mamejay/C64-USB-C-PD-Power-Adapter/Docs/top_3d_routed.png

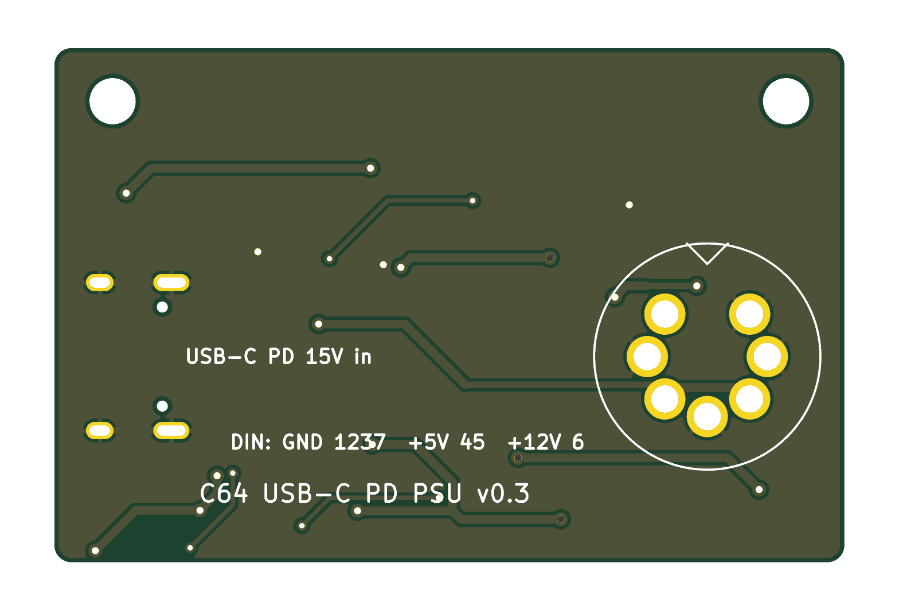
Docs/top_3d_routed.png
