mamejay/C64-USB-C-PD-Power-Adapter/Hardware v0.4/Docs/routing_plot.png

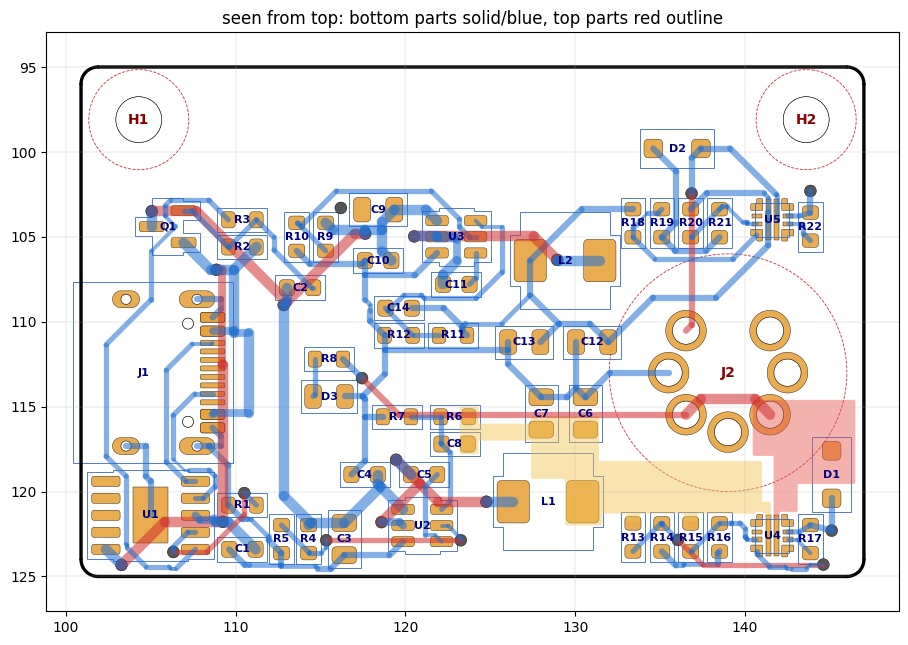
Hardware v0.4/Docs/routing_plot.png
