mamejay/C64-USB-C-PD-Power-Adapter/Hardware v0.4/Docs/top_3d.png

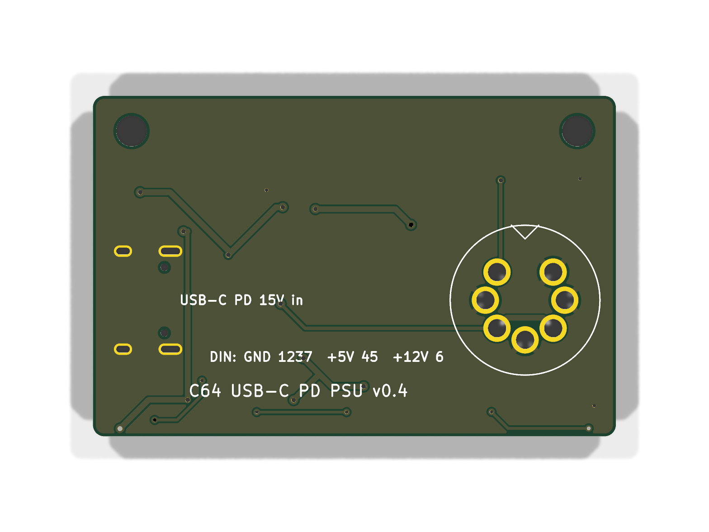
Hardware v0.4/Docs/top_3d.png
