mamejay/C64-USB-C-PD-Power-Adapter/Hardware v0.4/JLCPCB Output/C64 USB-C PD Power Adapter - BOM.csv

Comment | Designator | Footprint | LCSC Part #
1uF/50V | C1 | 0603 | C15849
100nF/50V | C2,C4,C5,C10,C11 | 0603 | C14663
10uF/25V | C3,C9 | 0805 | C15850
22uF/25V | C6,C7,C12,C13 | 0805 | C45783
100pF | C8,C14 | 0603 | C14858
SMF5.0A | D1 | SOD-123F | C19077497
SMF13A | D2 | SOD-123F | C41376087
GREEN | D3 | 0805 | C2297
USB-C (power in) | J1 | TYPE-C-31-M-12 | C165948
10uH | L1,L2 | FXL0530 | C177248
AO3401A | Q1 | SOT-23 | C15127
56k | R1 | 0603 | C23206
100k | R2,R3,R11,R13 | 0603 | C25803
470k | R4,R9 | 0603 | C23178
47k | R5,R10,R14,R18 | 0603 | C25819
75k | R6,R15 | 0603 | C23242
10k | R7,R19 | 0603 | C25804
1k | R8,R17 | 0603 | C21190
5.1k | R12 | 0603 | C23186
20k | R16 | 0603 | C4184
51k | R20 | 0603 | C23196
4.7k | R21 | 0603 | C23162
2.2k | R22 | 0603 | C4190
CH224A | U1 | SSOP-10 | C42459160
TPS54302DDCR | U2,U3 | TSOT-23-6 | C311983
TPS259470ARPWR | U4,U5 | TI_RPW0010A_VQFN-10-HR_2x2mm | C3662799
