mamejay/C64-USB-C-PD-Power-Adapter/C128 Version/JLCPCB Output/C128 USB-C PD Power Adapter - BOM.csv

Comment | Designator | Footprint | LCSC Part #
1uF/50V | C1,C16 | 0603 | C15849
100nF/50V | C2,C4,C5,C10,C11,C17 | 0603 | C14663
10uF/25V | C3,C9,C15 | 0805 | C15850
22uF/25V | C6,C7,C12,C13,C18 | 0805 | C45783
100pF | C14 | 0603 | C14858
SMF5.0A | D1 | SOD-123F | C19077497
SMF13A | D2 | SOD-123F | C41376087
GREEN | D3 | 0805 | C2297
0R | F2 | 1206 | C17888
USB-C (power in) | J1 | TYPE-C-31-M-12 | C165948
4.7uH | L1 | L_Cenker_CKCS8040 | C354638
10uH | L2 | FXL0530 | C177248
AO3401A | Q1 | SOT-23 | C15127
56k | R1 | 0603 | C23206
100k | R2,R3,R11,R13,R15 | 0603 | C25803
470k | R4,R9 | 0603 | C23178
51k | R5 | 0603 | C23196
75k | R6 | 0603 | C23242
10k | R7 | 0603 | C25804
1k | R8 | 0603 | C21190
47k | R10,R14 | 0603 | C25819
5.1k | R12 | 0603 | C23186
27k | R16 | 0603 | C22967
750R | R17 | 0603 | C23241
CH224A | U1 | SSOP-10 | C42459160
SY8205FCC | U2 | SOIC-8-1EP_3.9x4.9mm_P1.27mm_EP2.41x3.3mm_ThermalVias | C111875
TPS54302DDCR | U3 | TSOT-23-6 | C311983
TPS259470ARPWR | U4 | TI_RPW0010A_VQFN-10-HR_2x2mm | C3662799
