mamejay/C64-USB-C-PD-Power-Adapter/Case (3D print)/c64_pd_psu_case_lid.stl

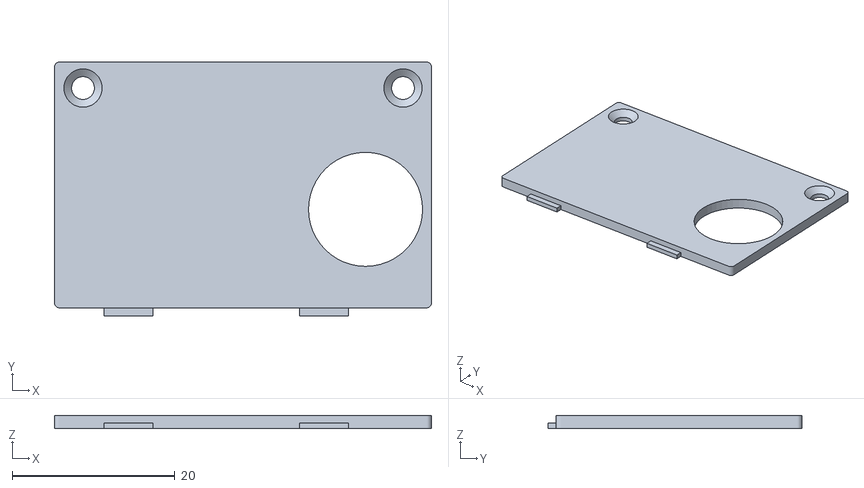
[picture p7: CAD file, 2026-11-03]
Case (3D print)/c64_pd_psu_case_lid.stl
46.3 x 31.2 x 1.60
