mamejay/C64-USB-C-PD-Power-Adapter/Case (3D print)/c64_pd_psu_case_base.stl

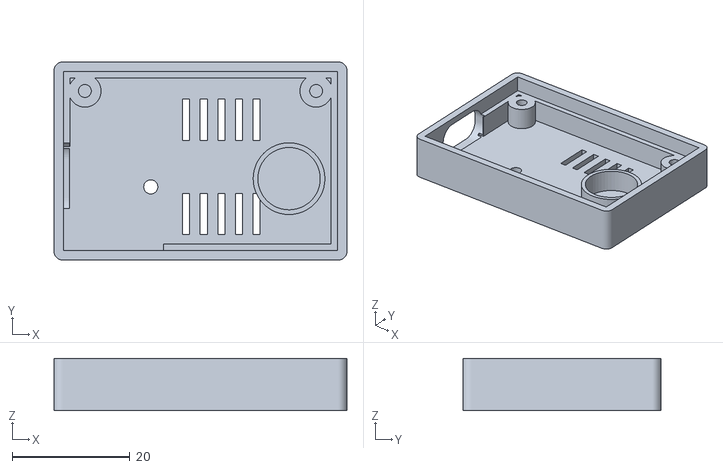
[picture p8: CAD file, 2026-11-03]
Case (3D print)/c64_pd_psu_case_base.stl
49.8 x 33.7 x 8.90
