mamejay/C64-USB-C-PD-Power-Adapter/Case (3D print)/render_base_under.png

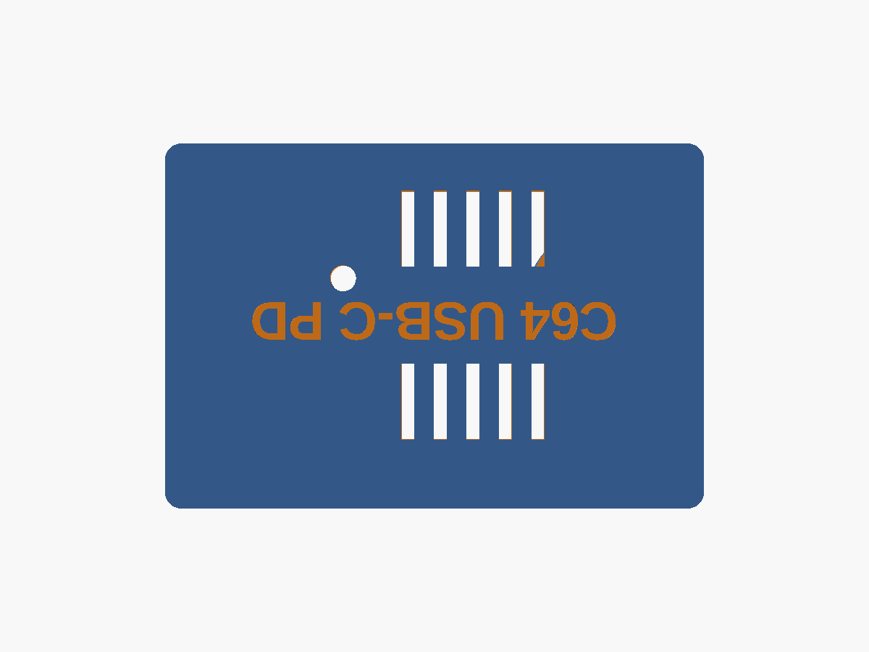
Case (3D print)/render_base_under.png
