mamejay/C64-USB-C-PD-Power-Adapter/Hardware v0.4/Docs/C64 USB-C PD Power Adapter v0.4 - schematic.pdf

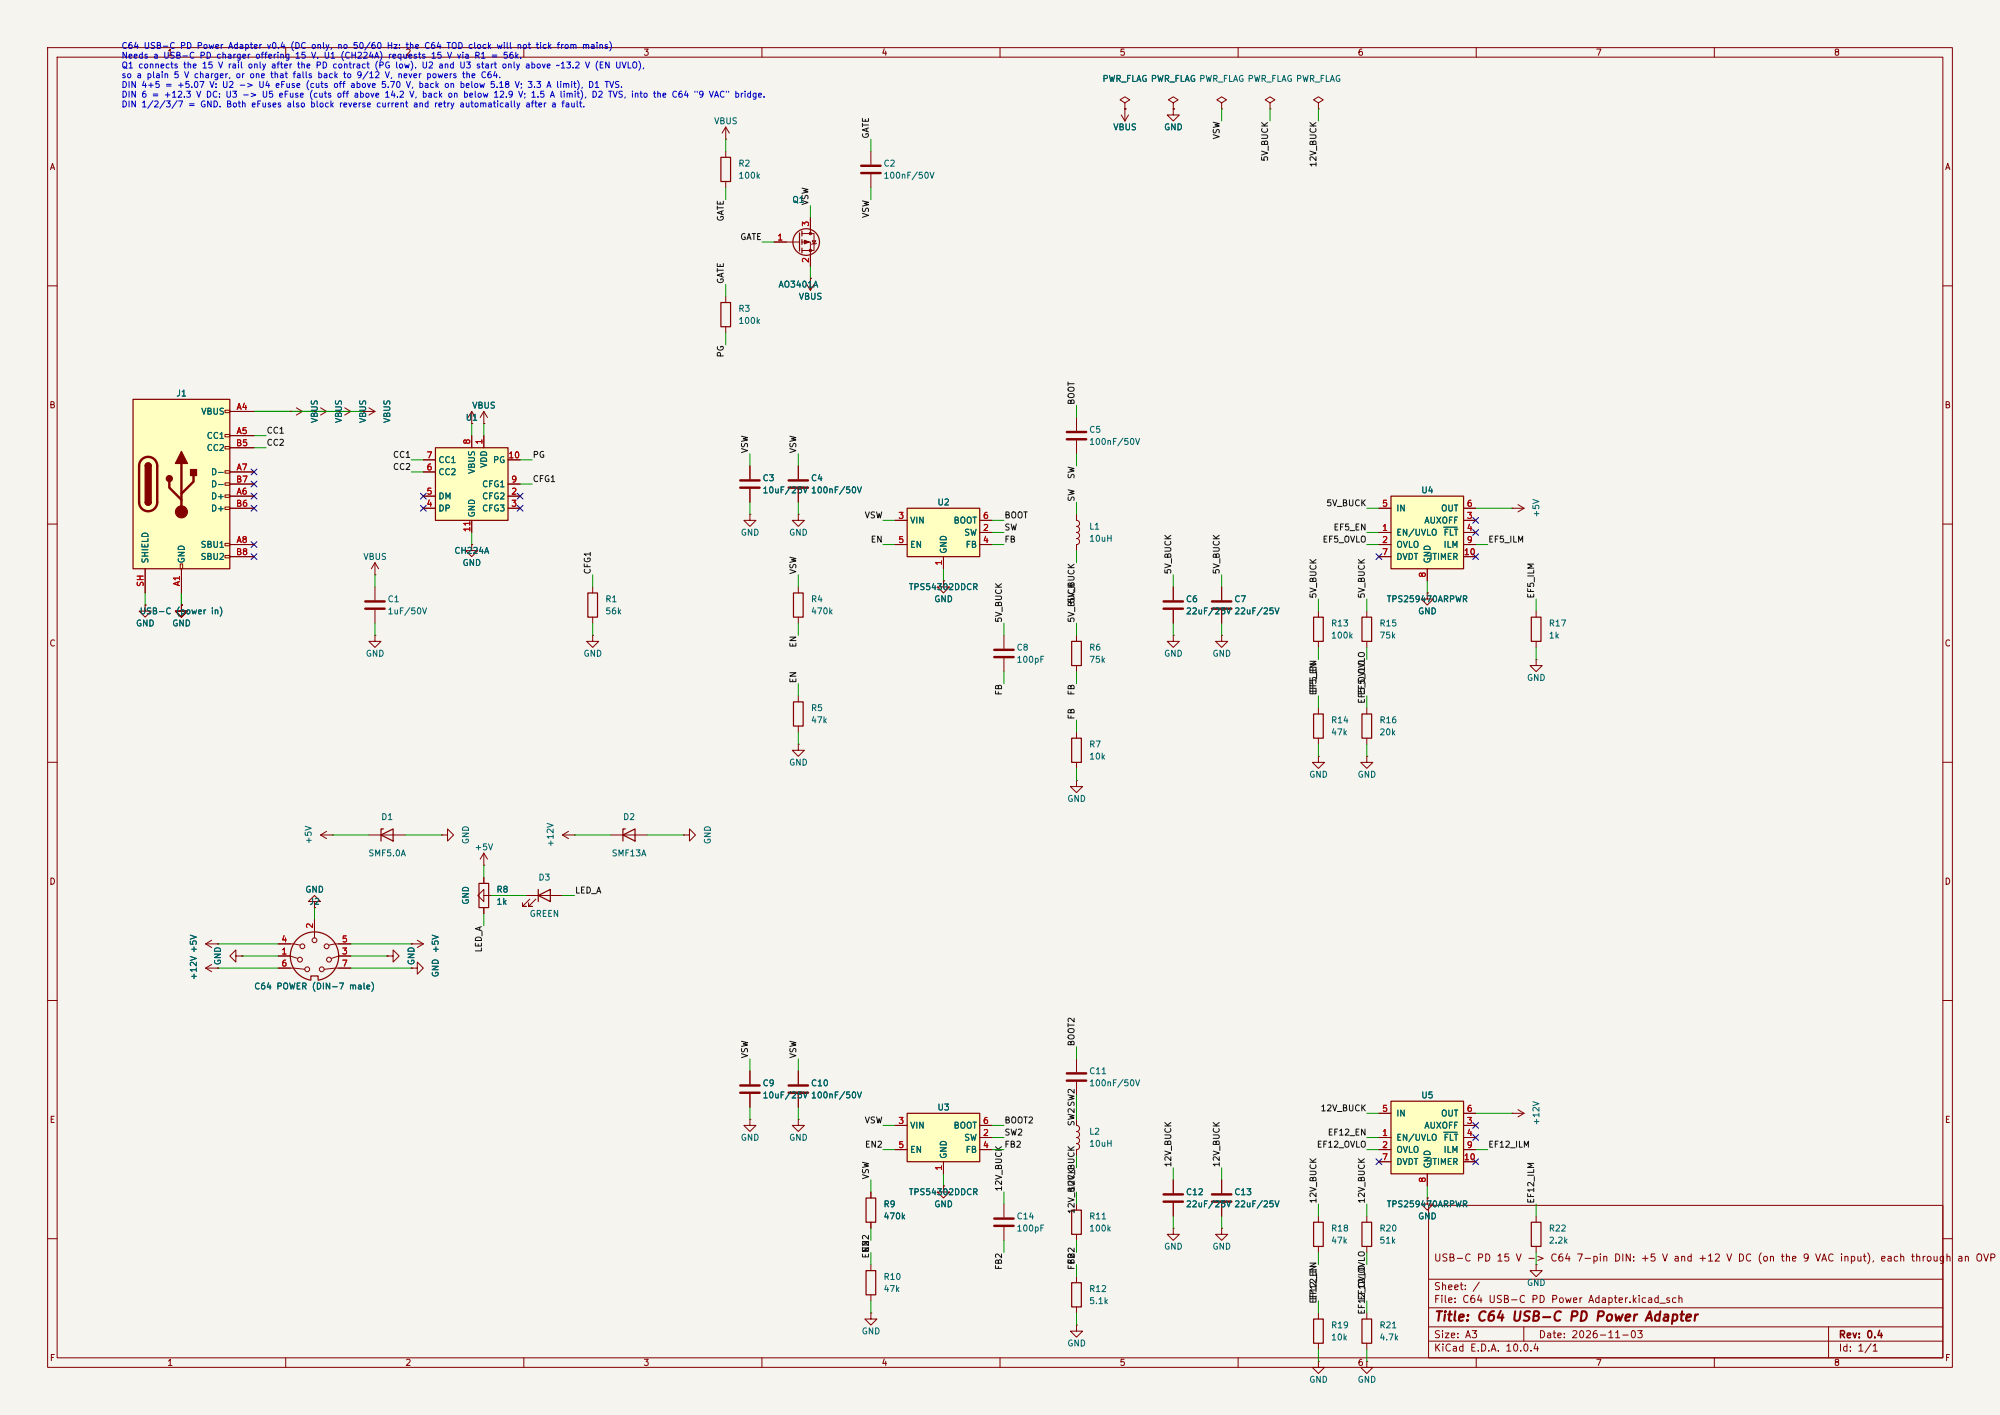
[picture p13: page 1]

J1 USB-C (power in) GND A1

8 CFG1 9 PG 10 GND 11 U1 CH224A GND VBUS GND

USB-C PD 15 V -> C64 7-pin DIN: +5 V and +12 V DC (on the 9 VAC input), each through an OVP eFuse

Sheet: /
File: C64 USB-C PD Power Adapter.kicad_sch
Title: C64 USB-C PD Power Adapter

Size: A3 | Rev: 0.4
KiCad E.D.A. 10.0.4 | Id: 1/1 | F Date: 2026-11-03
