mamejay/C64-USB-C-PD-Power-Adapter/C128 Version/Docs/C128 USB-C PD Power Adapter - schematic.pdf

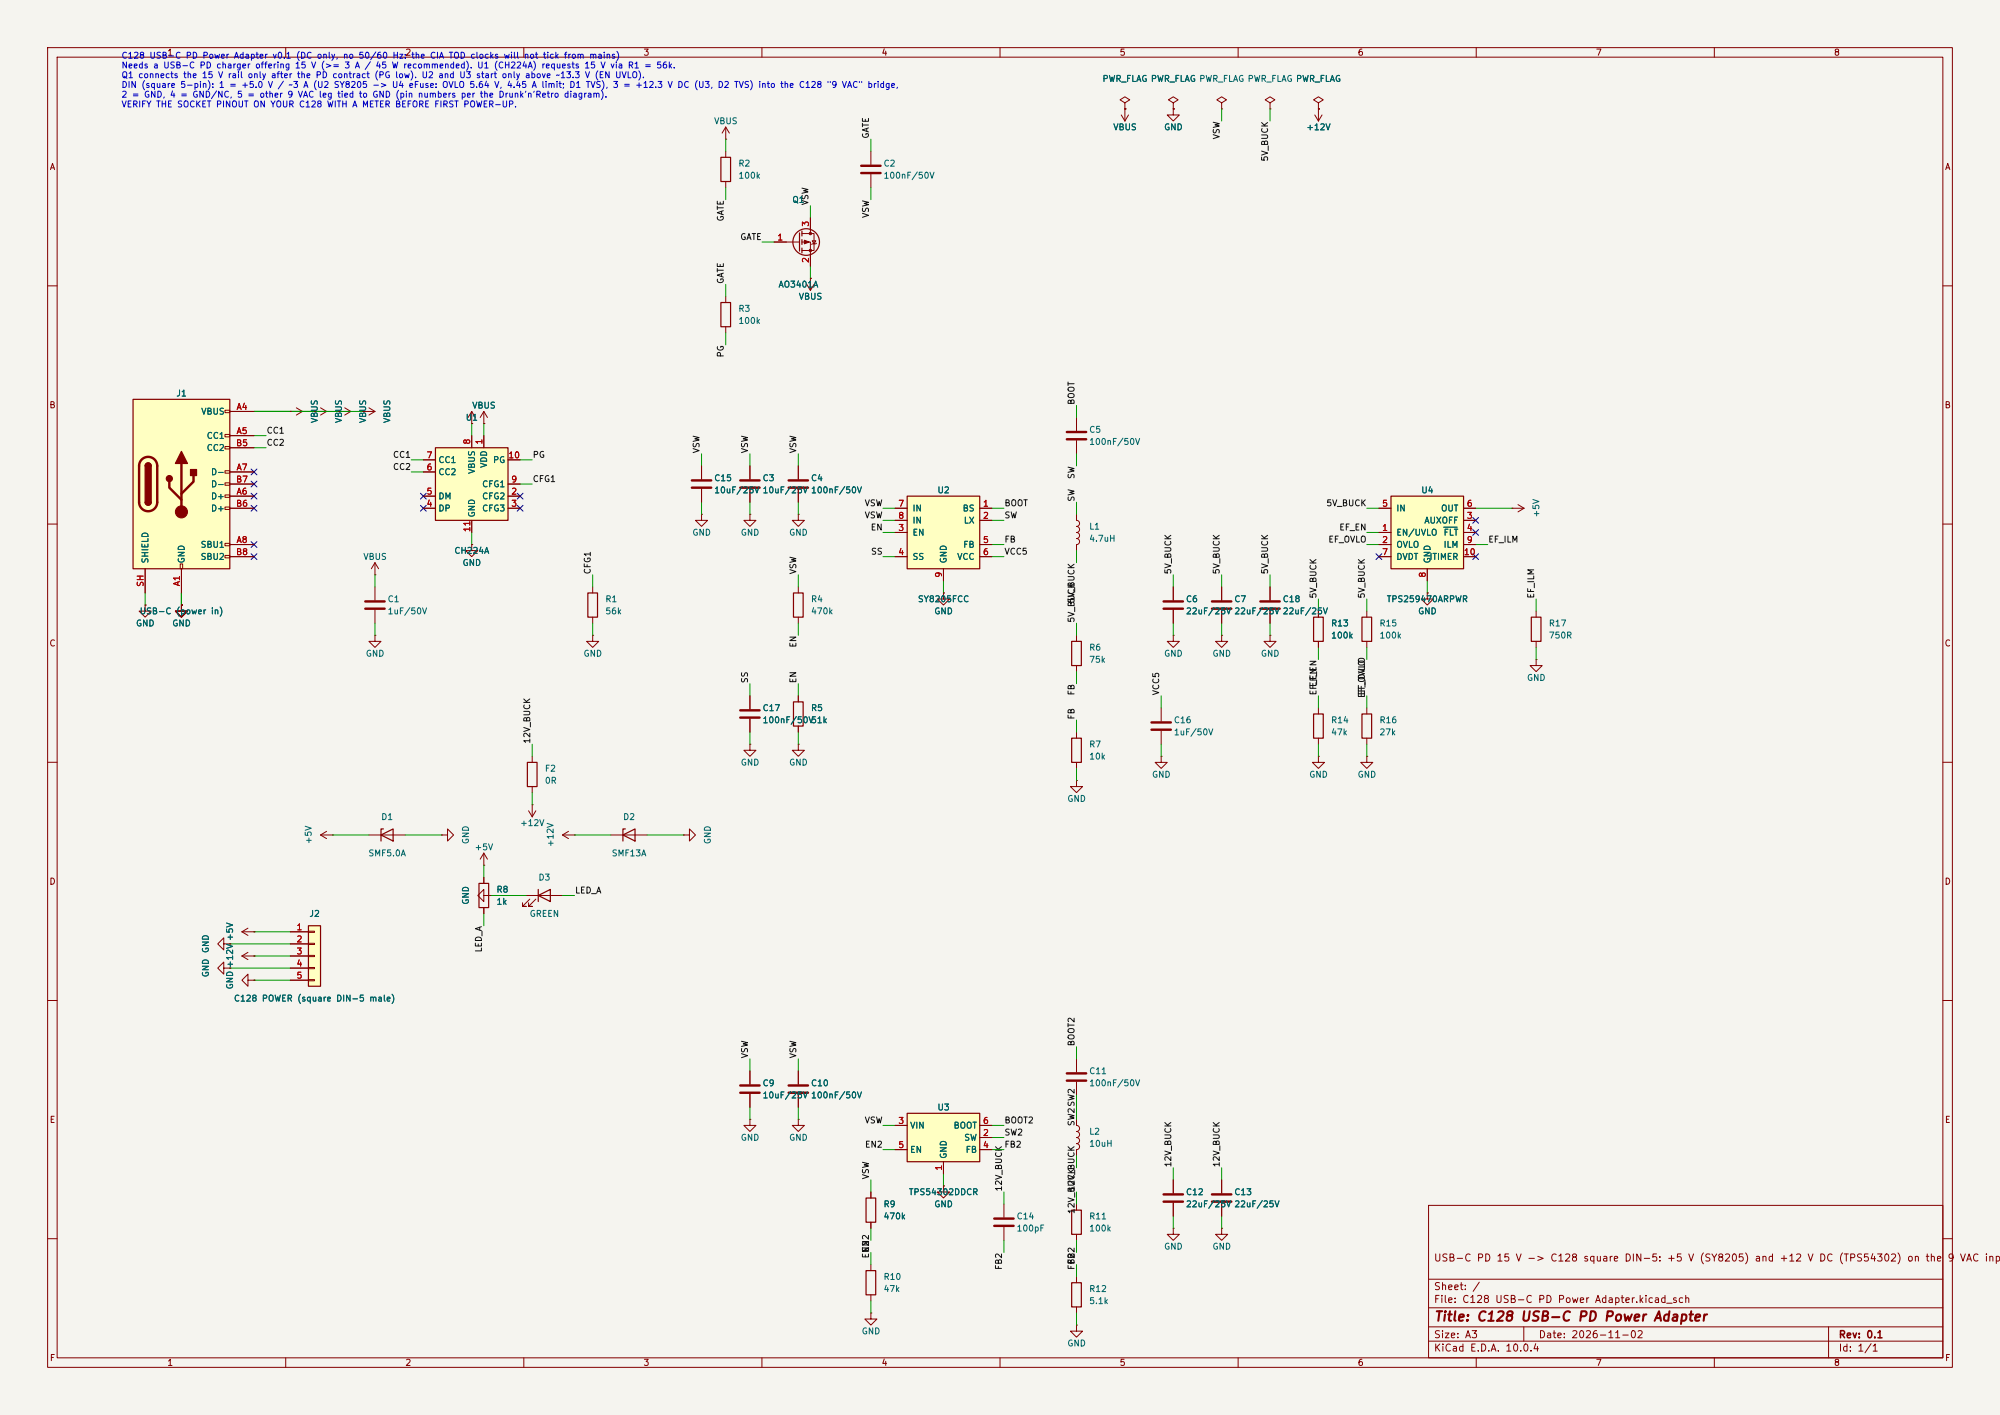
[picture p14: page 1]

J1 USB-C (power in) GND A1

8 CFG1 9 PG 10 GND 11 VBUS GND VBUS VBUS VBUS VBUS +5V GND +12V GND GND GNDR8

J2 C128 POWER (square DIN-5 male)

J2 C128 POWER (square DIN-5 male) 1

Sheet: /
File: C128 USB-C PD Power Adapter.kicad_sch
Title: C128 USB-C PD Power Adapter

Size: A3 | Rev: 0.1
KiCad E.D.A. 10.0.4 | Id: 1/1 | F Date: 2026-11-02
