mamejay/C64-USB-C-PD-Power-Adapter/Hardware v0.4/KiCad/C64 USB-C PD Power Adapter.kicad_pcb

## KiCad design Hardware v0.4/KiCad/C64 USB-C PD Power Adapter.kicad_pcb (2026-11-03)

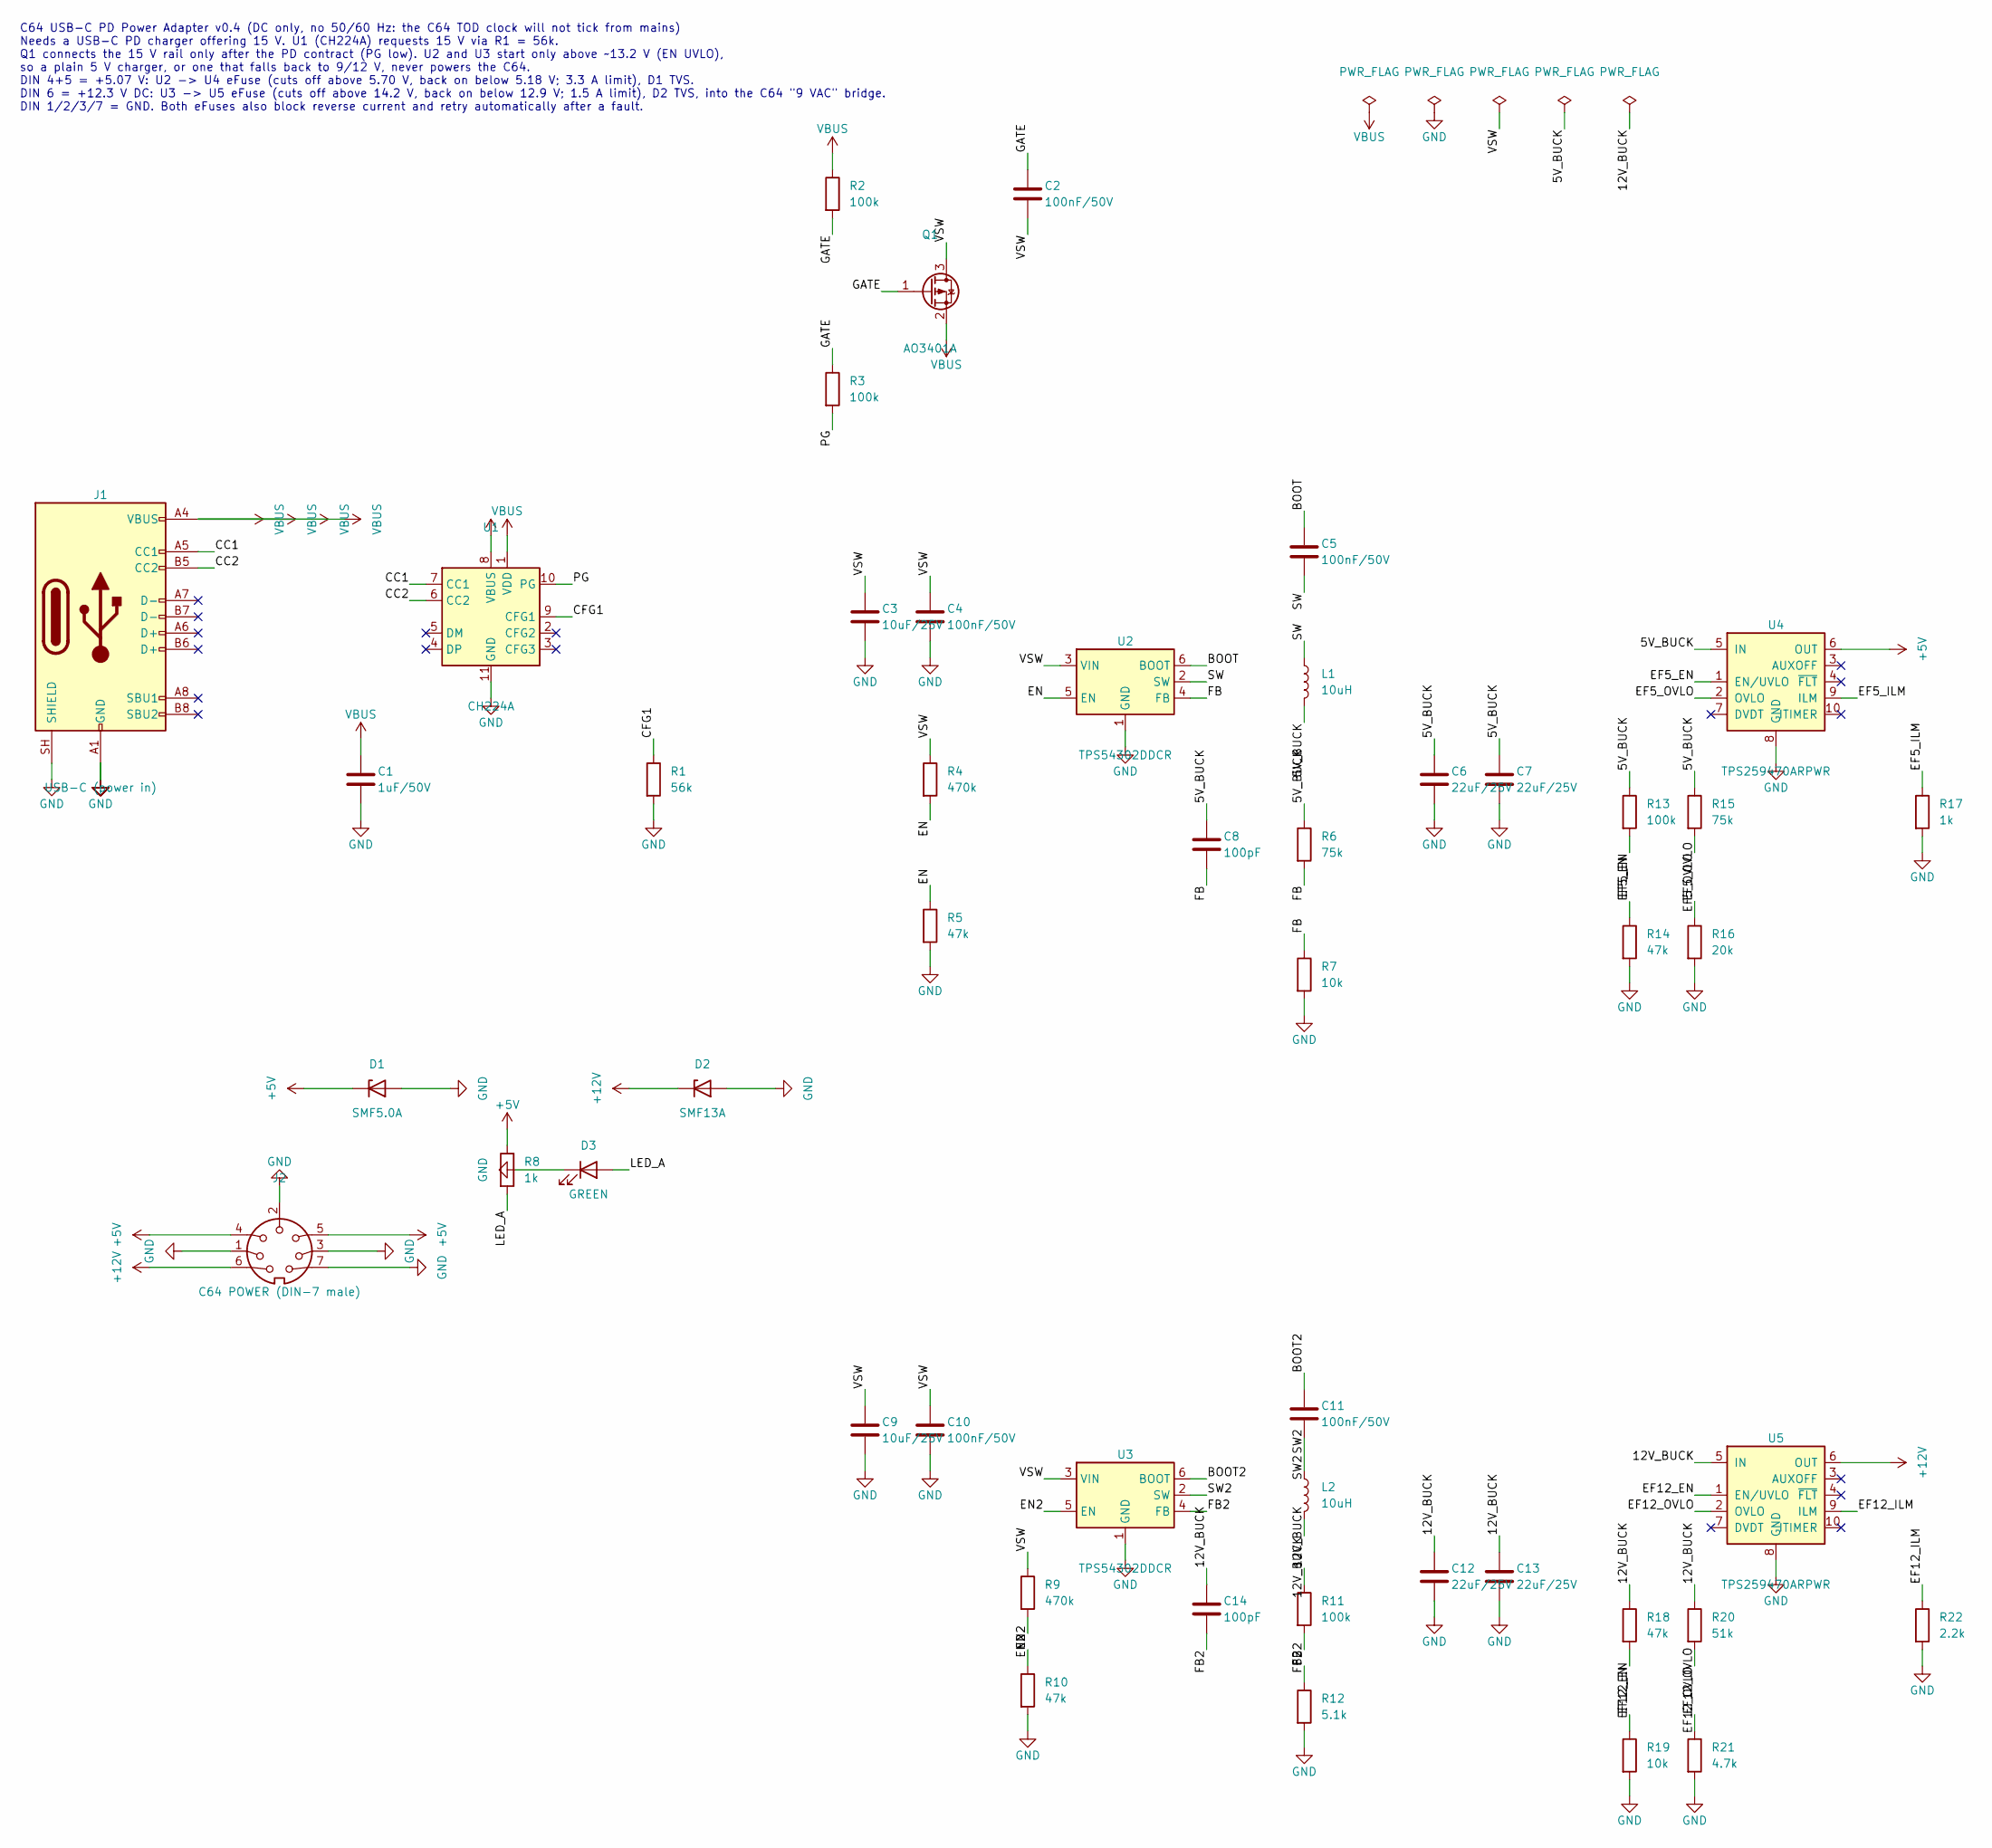
[picture p15: schematic C64 USB-C PD Power Adapter.kicad_sch]

Parts:
C1: 1uF/50V; C_0603_1608Metric; LCSC C15849
C2, C4, C5, C10, C11: 100nF/50V; C_0603_1608Metric; LCSC C14663
C3, C9: 10uF/25V; C_0805_2012Metric; LCSC C15850
C6, C7, C12, C13: 22uF/25V; C_0805_2012Metric; LCSC C45783
C8, C14: 100pF; C_0603_1608Metric; LCSC C14858
D1: SMF5.0A; D_SOD-123F; LCSC C19077497
D2: SMF13A; D_SOD-123F; LCSC C41376087
D3: GREEN; LED_0805_2012Metric; LCSC C2297
J1: USB-C (power in); USB_C_Receptacle_HRO_TYPE-C-31-M-12; LCSC C165948
J2: C64 POWER (DIN-7 male); DIN-7_Male_PCB_C64
L1, L2: 10uH; L_Changjiang_FXL0530; LCSC C177248
Q1: AO3401A; SOT-23; LCSC C15127
R1: 56k; R_0603_1608Metric; LCSC C23206
R2, R3, R11, R13: 100k; R_0603_1608Metric; LCSC C25803
R4, R9: 470k; R_0603_1608Metric; LCSC C23178
R5, R10, R14, R18: 47k; R_0603_1608Metric; LCSC C25819
R6, R15: 75k; R_0603_1608Metric; LCSC C23242
R7, R19: 10k; R_0603_1608Metric; LCSC C25804
R8, R17: 1k; R_0603_1608Metric; LCSC C21190
R12: 5.1k; R_0603_1608Metric; LCSC C23186
R16: 20k; R_0603_1608Metric; LCSC C4184
R20: 51k; R_0603_1608Metric; LCSC C23196
R21: 4.7k; R_0603_1608Metric; LCSC C23162
R22: 2.2k; R_0603_1608Metric; LCSC C4190
U1: CH224A; SSOP-10-1EP_3.9x4.9mm_P1mm_EP2.1x3.3mm; LCSC C42459160
U2, U3: TPS54302DDCR; TSOT-23-6; LCSC C311983
U4, U5: TPS259470ARPWR; TI_RPW0010A_VQFN-10-HR_2x2mm; LCSC C3662799

Connections:
+5V: D1.1 (K), J2.4, J2.5, R8.1, U4.6 (OUT)
+12V: D2.1 (K), J2.6, U5.6 (OUT)
/5V_BUCK: C6.1, C7.1, C8.1, L1.2, R6.1, R13.1, R15.1, U4.5 (IN)
/12V_BUCK: C12.1, C13.1, C14.1, L2.2, R11.1, R18.1, R20.1, U5.5 (IN)
/BOOT: C5.1, U2.6 (BOOT)
/BOOT2: C11.1, U3.6 (BOOT)
/CC1: J1.A5 (CC1), U1.7 (CC1)
/CC2: J1.B5 (CC2), U1.6 (CC2)
/CFG1: R1.1, U1.9 (CFG1)
/EF5_EN: R13.2, R14.1, U4.1 (EN/UVLO)
/EF5_ILM: R17.1, U4.9 (ILM)
/EF5_OVLO: R15.2, R16.1, U4.2 (OVLO)
/EF12_EN: R18.2, R19.1, U5.1 (EN/UVLO)
/EF12_ILM: R22.1, U5.9 (ILM)
/EF12_OVLO: R20.2, R21.1, U5.2 (OVLO)
/EN: R4.2, R5.1, U2.5 (EN)
/EN2: R9.2, R10.1, U3.5 (EN)
/FB: C8.2, R6.2, R7.1, U2.4 (FB)
/FB2: C14.2, R11.2, R12.1, U3.4 (FB)
/GATE: C2.1, Q1.1 (G), R2.2, R3.1
/LED_A: D3.2 (A), R8.2
/PG: R3.2, U1.10 (PG)
/SW: C5.2, L1.1, U2.2 (SW)
/SW2: C11.2, L2.1, U3.2 (SW)
/VSW: C2.2, C3.1, C4.1, C9.1, C10.1, Q1.3 (D), R4.1, R9.1, U2.3 (VIN), U3.3 (VIN)
GND: C1.2, C3.2, C4.2, C6.2, C7.2, C9.2, C10.2, C12.2, C13.2, D1.2 (A), D2.2 (A), D3.1 (K), J1.A1 (GND), J1.A12 (GND), J1.B1 (GND), J1.B12 (GND), J1.SH (SHIELD), J2.1, J2.2, J2.3, J2.7, R1.2, R5.2, R7.2, R10.2, R12.2, R14.2, R16.2, R17.2, R19.2, R21.2, R22.2, U1.11 (GND), U2.1 (GND), U3.1 (GND), U4.8 (GND), U5.8 (GND)
VBUS: C1.1, J1.A4 (VBUS), J1.A9 (VBUS), J1.B4 (VBUS), J1.B9 (VBUS), Q1.2 (S), R2.1, U1.1 (VDD), U1.8 (VBUS)

Notes on the sheet:
C64 USB-C PD Power Adapter v0.4 (DC only, no 50/60 Hz: the C64 TOD clock will not tick from mains) Needs a USB-C PD charger offering 15 V. U1 (CH224A) requests 15 V via R1 = 56k. Q1 connects the 15 V rail only after the PD contract (PG low). U2 and U3 start only above ~13.2 V (EN UVLO), so a plain 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

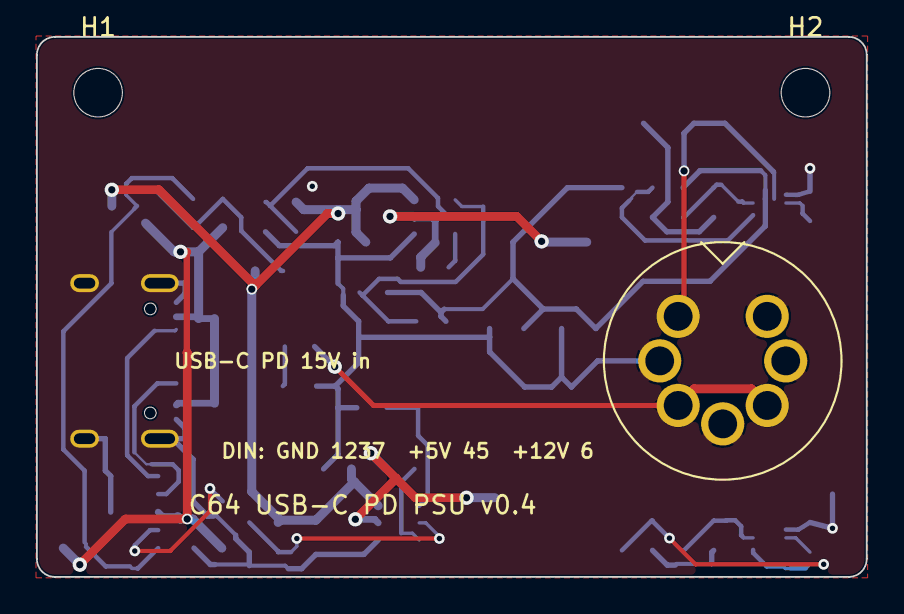
[picture p16: board C64 USB-C PD Power Adapter.kicad_pcb from above]

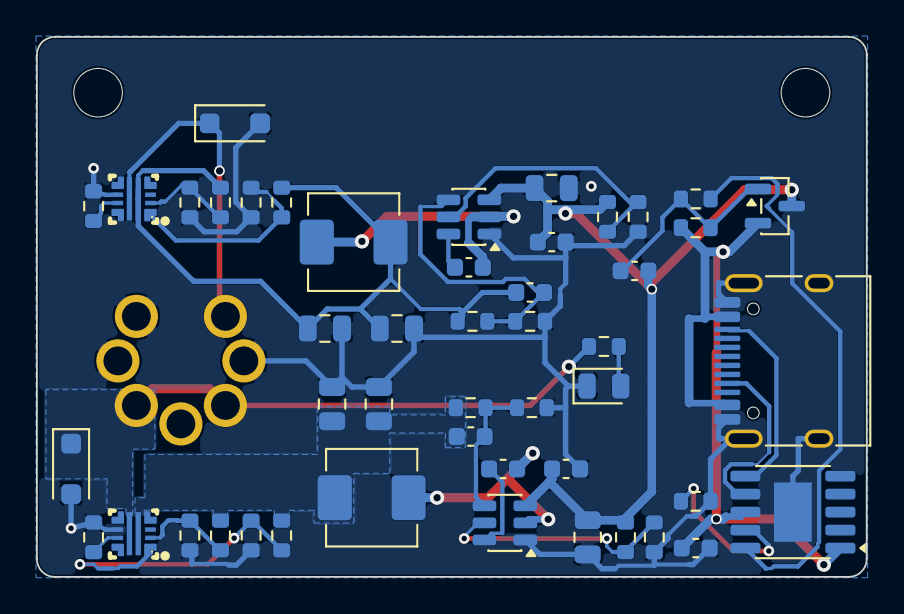
[picture p17: board C64 USB-C PD Power Adapter.kicad_pcb from below]

Board: 2 copper layers, 46.1 x 30.0 mm, 51 parts (48 on the bottom side), 27 nets.

Other parts of the board:
H1, H2: M2.5; MountingHole_2.7mm_M2.5
