mamejay/C64-USB-C-PD-Power-Adapter/(commit log)

2026-10-27 C64 USB-C PD Power Adapter v0.2: routed board and JLCPCB outputs
    USB-C PD (CH224A, 15 V) to C64 7-pin DIN: +5 V and +12 V DC from two
    TPS54302 bucks, PG-gated output switch, PTC + TVS protection.
    DIN-7 male soldered through the board, all SMD on the bottom.
    [C64 USB-C PD Power Adapter - BOM.csv, C64 USB-C PD Power Adapter.kicad_pcb, C64 USB-C PD Power Adapter.kicad_sch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]
2026-10-27 v0.3: cut JLC extended parts from 15 to 4, 0603 passives
    All 0402 parts moved to 0603 JLC Basic; TVS diodes swapped to Preferred
    parts; L1 now the same FXL0530 as L2; PTCs replaced by Basic 0R links
    (footprints still take a 1206 PTC); 5 V feedback 75k/10k. Board rebuilt
    from the user's placement, re-routed (DRC clean). CPL now carries the
    U1-U3 +90 fix confirmed in JLC's preview.
    [C64 USB-C PD Power Adapter - BOM.csv, C64 USB-C PD Power Adapter.kicad_pcb, C64 USB-C PD Power Adapter.kicad_sch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]
2026-10-27 Add 3D-printed case (OpenSCAD base + lid, STLs)
    Base tray on the parts side with USB-C opening, standoffs, DIN support
    ring, edge ledges, LED window and vents; lid with DIN hole, flush
    countersunk M2.5 screws and hook tabs. Not test-printed yet.
    [c64_pd_psu_case.scad, c64_pd_psu_case_base.stl, c64_pd_psu_case_lid.stl]
2026-11-02 Add C128 version v0.1 (square DIN-5 via round DIN-8 insert, SY8205 5 A +5V)
    [C128 USB-C PD Power Adapter - BOM.csv, C128 USB-C PD Power Adapter.kicad_pcb, C128 USB-C PD Power Adapter.kicad_sch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]
2026-11-02 C128 v0.1: TPS259470A eFuse on +5V (5.64 V OVLO, 4.45 A limit), DIN 4.5 mm from edge, solid 5 V copper path
    [C128 USB-C PD Power Adapter - BOM.csv, C128 USB-C PD Power Adapter.kicad_pcb, C128 USB-C PD Power Adapter.kicad_sch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]
2026-11-03 Case: remove all text except the C64 USB-C PD label
    Drops the '15V PD in' base label (it also overlapped the vent slots) and the
    '+5V 4/5 +12V 6' lid legend. STLs and renders regenerated.
    [c64_pd_psu_case.scad, c64_pd_psu_case_base.stl, c64_pd_psu_case_lid.stl]
2026-11-03 Add v0.4: TPS259470A eFuse over-voltage protection on +5 V and +12 V
    U4 on +5 V: off above 5.70 V, 3.3 A limit. U5 on 12 V: off above 14.2 V,
    1.5 A limit. Both replace the v0.3 0R links F1/F2 and block reverse current.
    Same 46.1 x 30 mm board and connector positions, so the v0.3 case fits.
    Routed, DRC 0 unconnected; JLC outputs included (U4/U5 rotation unverified).
    [C64 USB-C PD Power Adapter - BOM.csv, C64 USB-C PD Power Adapter.kicad_pcb, C64 USB-C PD Power Adapter.kicad_sch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]
